aiexr/sdvx-controller/README.md

# Overview
This project is not intended to be a guide. I am documenting how I was able to build a controller as a beginner. This project was primarily a learning experience for me, and I hope to share what I learned.

A Sound Voltex controller itself has 7 buttons and 2 rotary encoders. The photo below shows the controls of a real cabinet.

SOUND VOLTEX controls

<small>image credit: https://ja.wikipedia.org/wiki/%E5%88%A9%E7%94%A8%E8%80%85:Sanjo</small>

# Demonstration
Below is the final product of what I made:

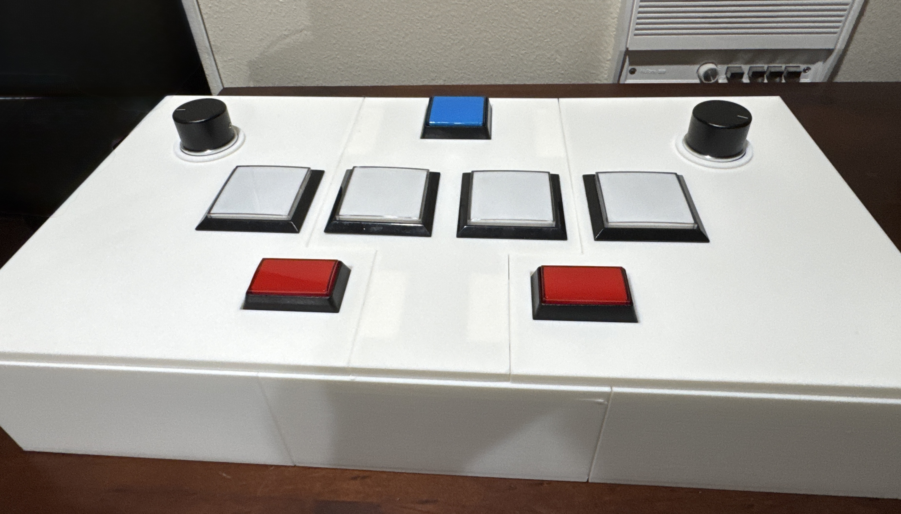
[picture p1: media/controller/complete.jpg]
Completed controller


<table>
  <tr>
    <td width="50%">
      <video src="https://github.com/user-attachments/assets/48bb6534-442d-47c3-9c97-483c5b49c126" width="100%" controls></video>
    </td>
    <td width="50%">
      <video src="https://github.com/user-attachments/assets/058fed3e-3493-4807-bf1f-01e18b2e095d" width="100%" controls></video>
    </td>
  </tr>
</table>

# Process

I chose an [Arduino Leonardo w/ headers](https://store-usa.arduino.cc/products/arduino-leonardo-with-headers) to power all inputs.  

For the **main buttons** (BT-A, BT-B, BT-C, BT-D), I was hoping to buy 60mm buttons to make it more accurate to the actual cabinet, and I found this push button on Adafruit: https://www.adafruit.com/product/6261. 50mm would have worked fine functionally, but I wanted accurate button dimensions. The rest of the parts were purchased on Amazon. 

| Item | Qty | Image |
| --- | --- | --- |
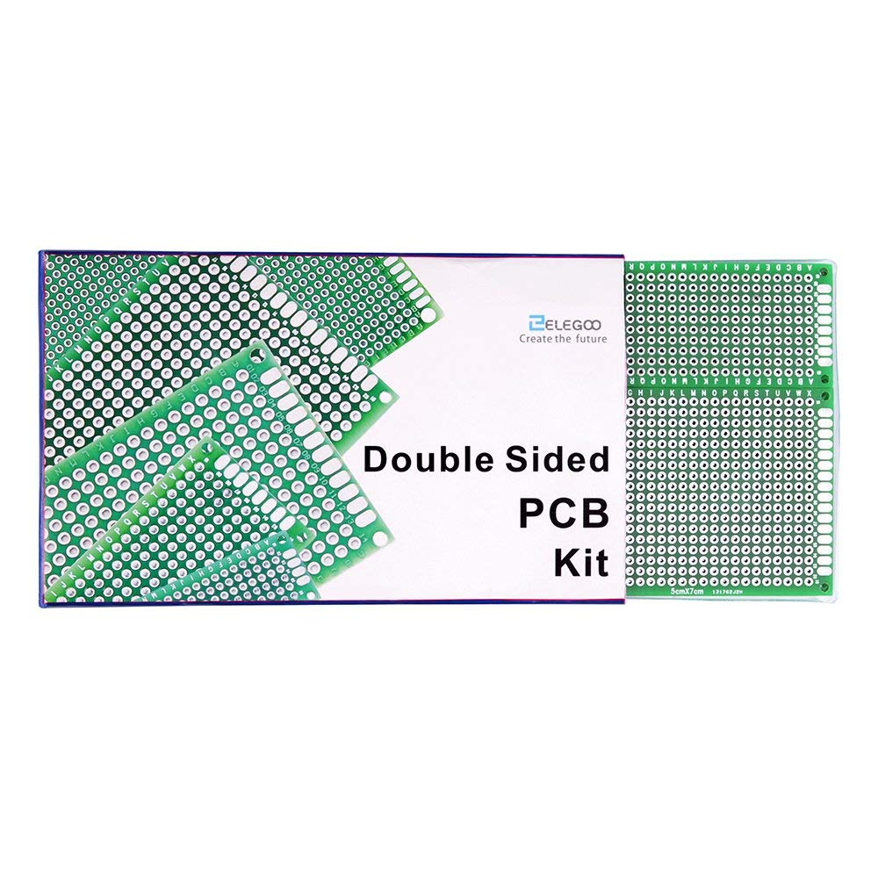
[picture p2: media/products/pcb.png]
PCB
| [Dot PCB](https://www.amazon.com/ELEGOO-Prototype-Soldering-Compatible-Arduino/dp/B072Z7Y19F/) | 1 |  |
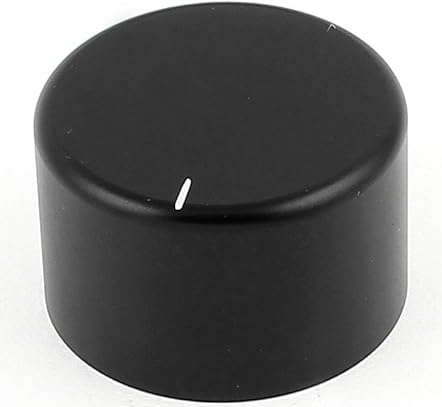
[picture p3: media/products/knob.png]
Knob
| [35x22 knob](https://www.amazon.com/dp/B00X73QARO?ref=ppx_yo2ov_dt_b_fed_asin_title) | 2 |  |
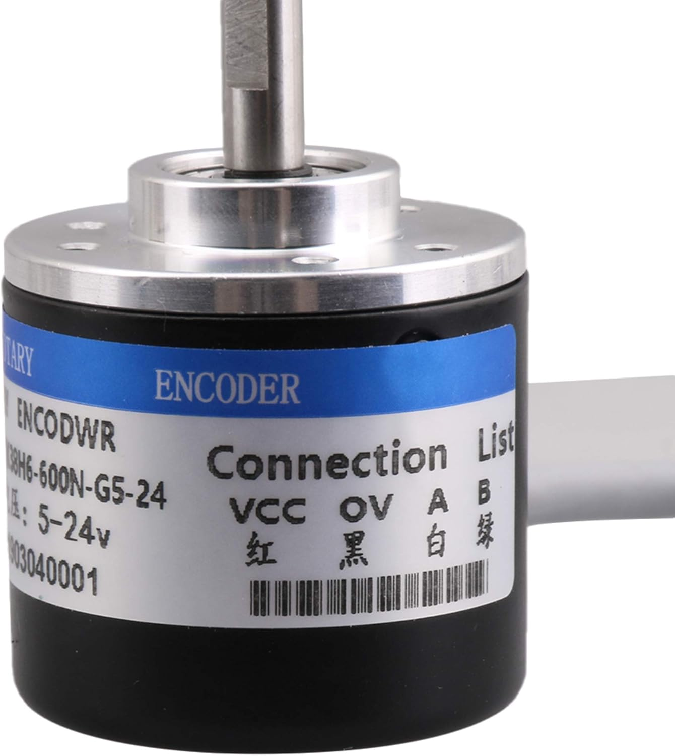
[picture p4: media/products/encoder.png]
Encoder
| [600p/r encoder](https://www.amazon.com/dp/B00UTIFCVA?ref=ppx_yo2ov_dt_b_fed_asin_title) | 2 |  |
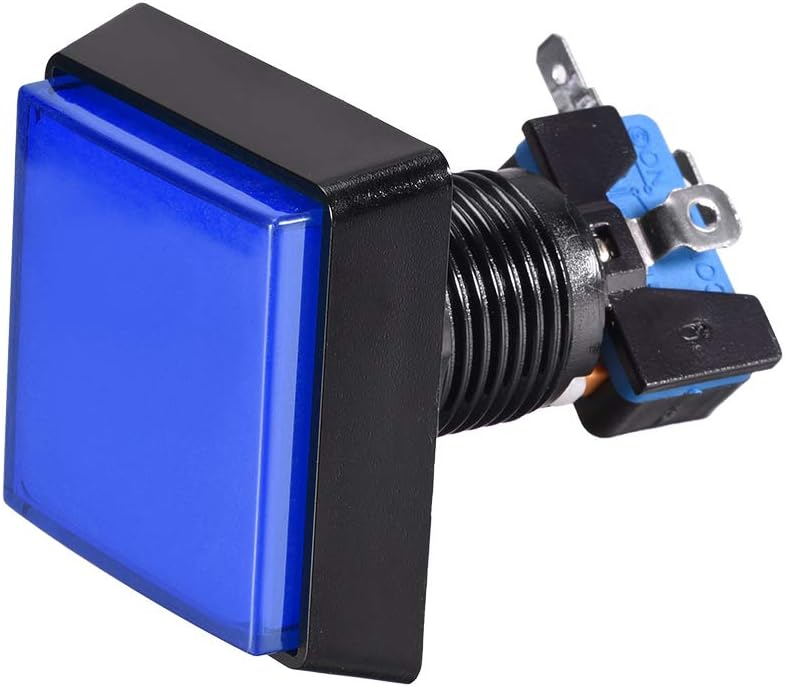
[picture p5: media/products/start.png]
Start button
| [50x50 pushbutton](https://www.amazon.com/dp/B07WNFFPG5?ref=ppx_yo2ov_dt_b_fed_asin_title) | 1 |  |
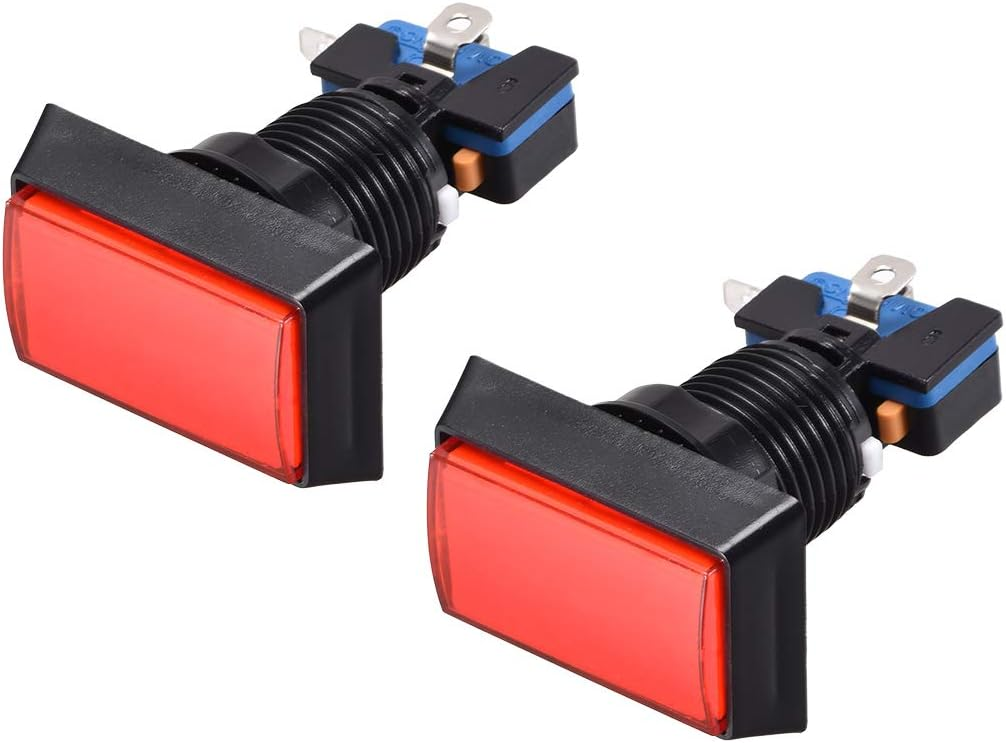
[picture p6: media/products/fx.png]
FX buttons
| [49x33 pushbutton](https://www.amazon.com/dp/B07WQSBSWD?ref=ppx_yo2ov_dt_b_fed_asin_title) | 2 |  |
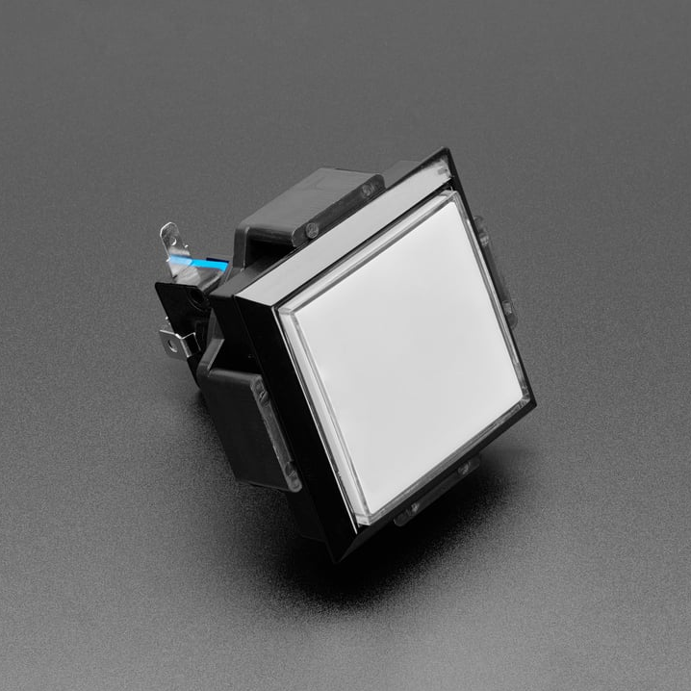
[picture p7: media/products/main-buttons.png]
Main buttons
| [60x60 Adafruit pushbutton](https://www.adafruit.com/product/6261) | 4 |  |

Filament used: ~600g of [Official Creality Hyper PLA Filament 1.75mm, High Speed PLA](https://www.amazon.com/dp/B0C2BJB256?ref=ppx_yo2ov_dt_b_fed_asin_title)

Print settings: 30% infill and 4 walls

Additionally:
- Fusion 360
- a 3D printer (used a Creality K1 Max) 
- Arduino Leonardo (used with headers)

## CAD files and printing
[Link to Fusion360 project](https://a360.co/48BC7ad), fully parametrized. 

Arduino sketch located in [`./CAD/sdvx_controller.ino`](./CAD/sdvx_controller.ino)

It requires this library: https://github.com/MHeironimus/ArduinoJoystickLibrary 

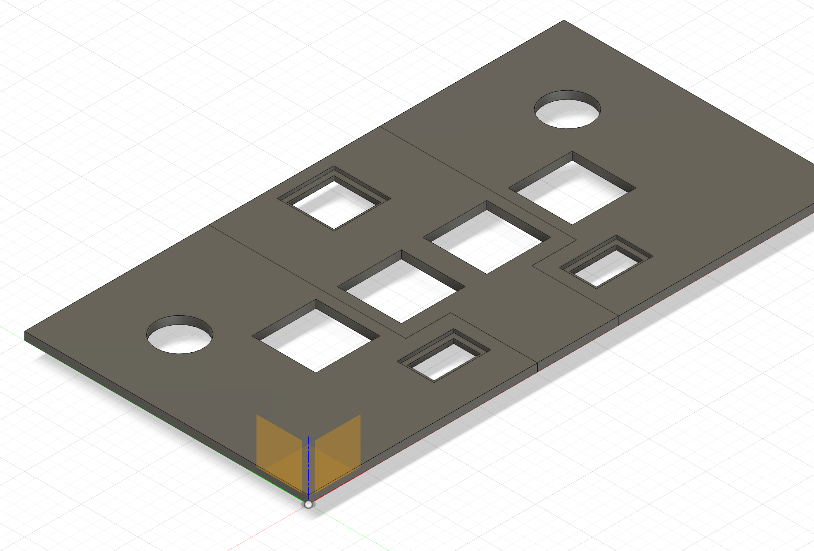
[picture p8: media/screenshots/plate.png]
Button plate


The uppermost part of the board holds the buttons in place. The dimensions of the cutouts on this part of the board are designed to allow each button to snap into place. With the exceptions of BT-A through BT-D (the Adafruit button already had an additional lip on the edge of each pushbutton), each button required an additional shelf to hold the button in place after being placed in its slot. 

This piece is also divided into three separate pieces that can be printed and connected horizontally. 

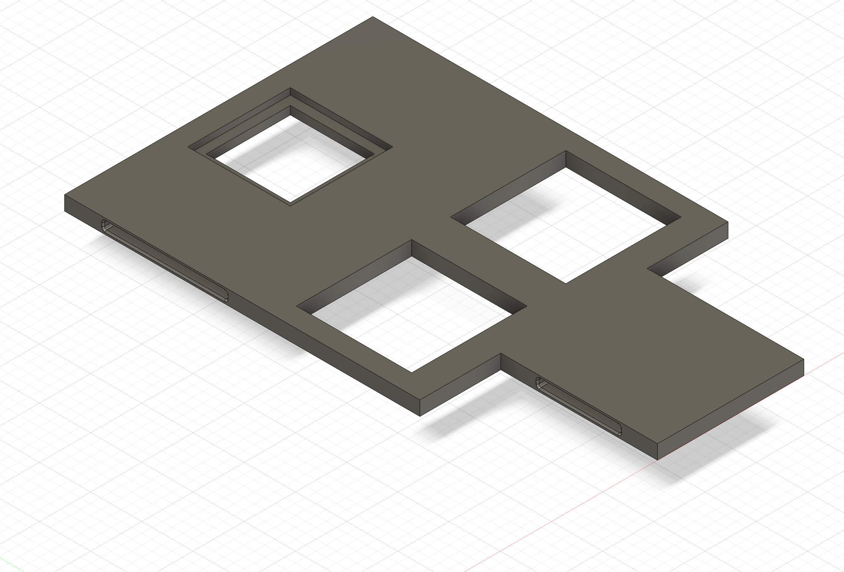
[picture p9: media/screenshots/plate_mid.png]
Button plate with mid piece

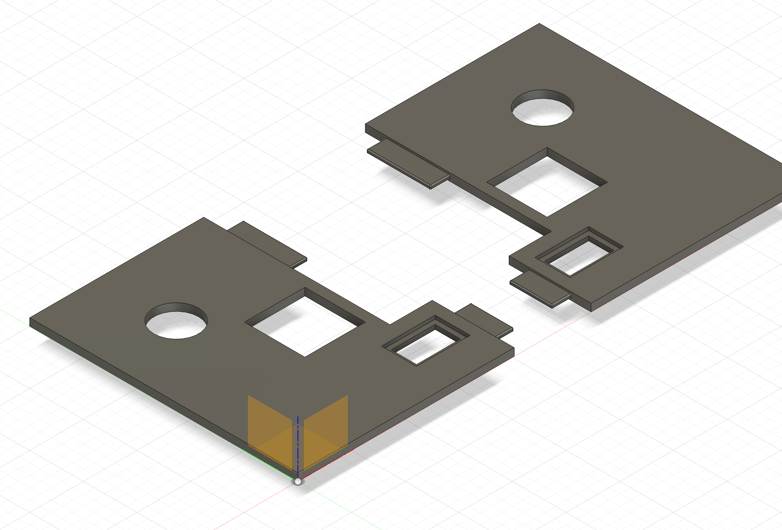
[picture p10: media/screenshots/plate_no_mid.png]
Button plate without mid piece


Shell pieces:

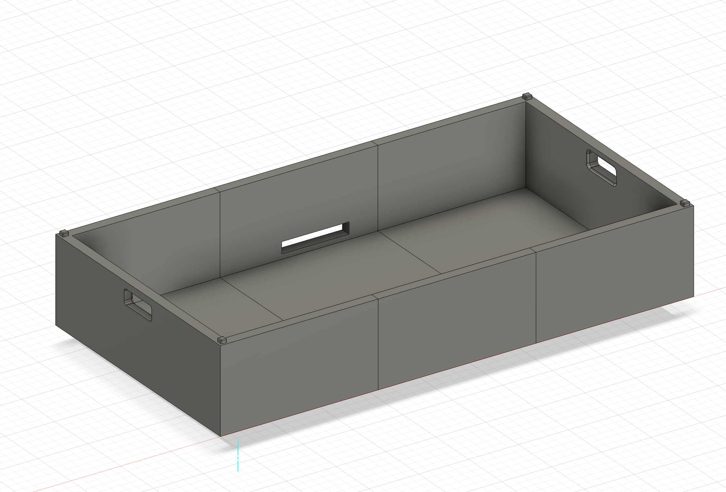
[picture p11: media/screenshots/shell.png]
Shell

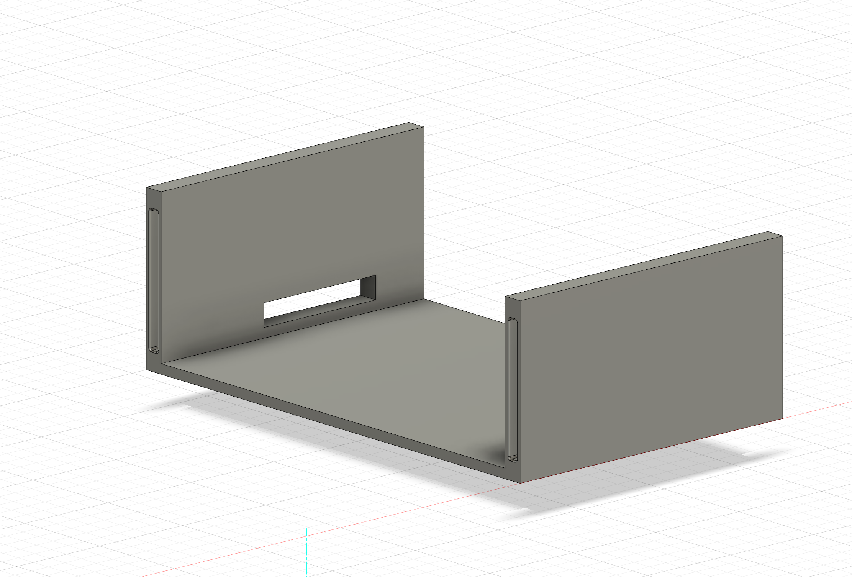
[picture p12: media/screenshots/shell_mid.png]
Shell with middle section

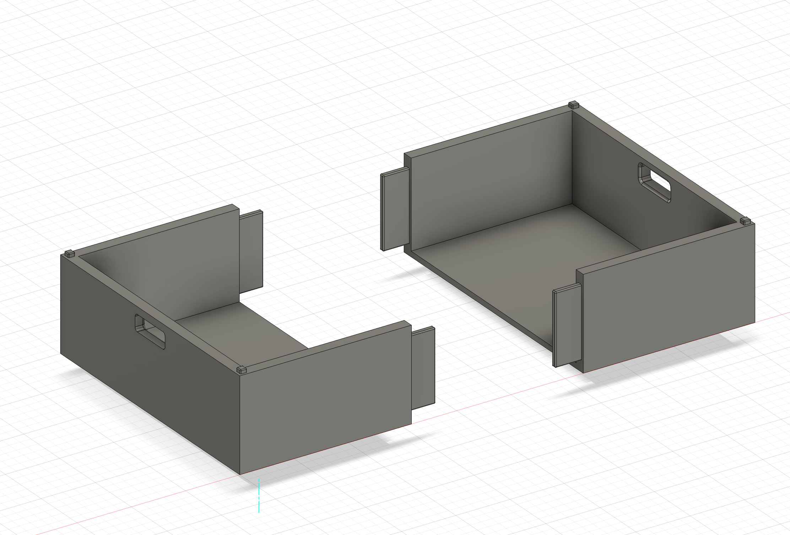
[picture p13: media/screenshots/shell_no_mid.png]
Shell without middle section


The encoder slot is meant to be used with two additional cutouts provided in the Fusion file and uploaded to this repository. 
One piece is an insert that holds the encoder right below the cutout, and another is a small piece that boosts the Z position of the encoder so that it is flush with the board. 

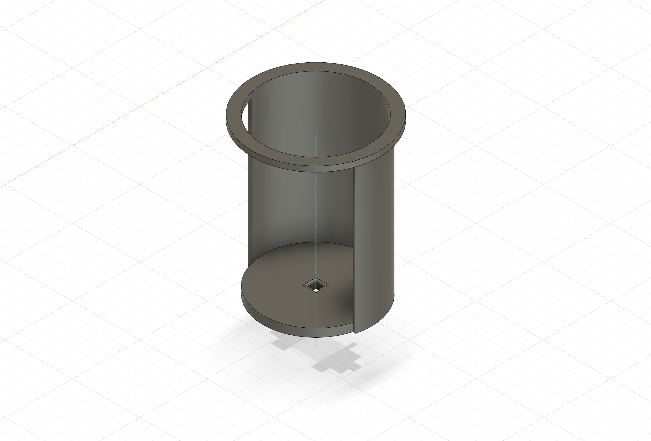
[picture p14: media/screenshots/encoder_shelf.png]
Encoder shelf

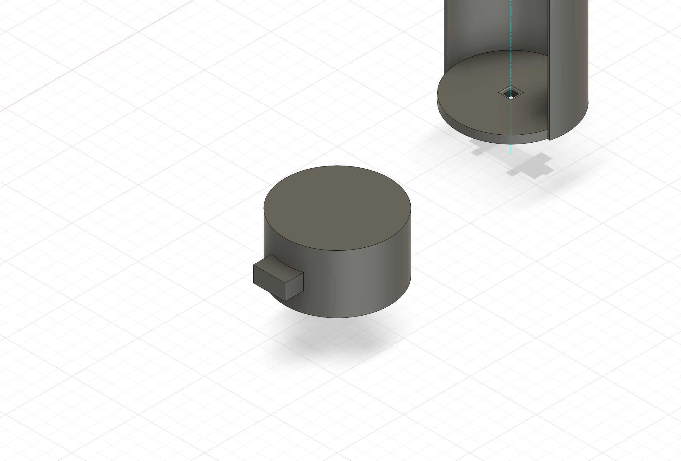
[picture p15: media/screenshots/encoder_step_stool.png]
Encoder step stool

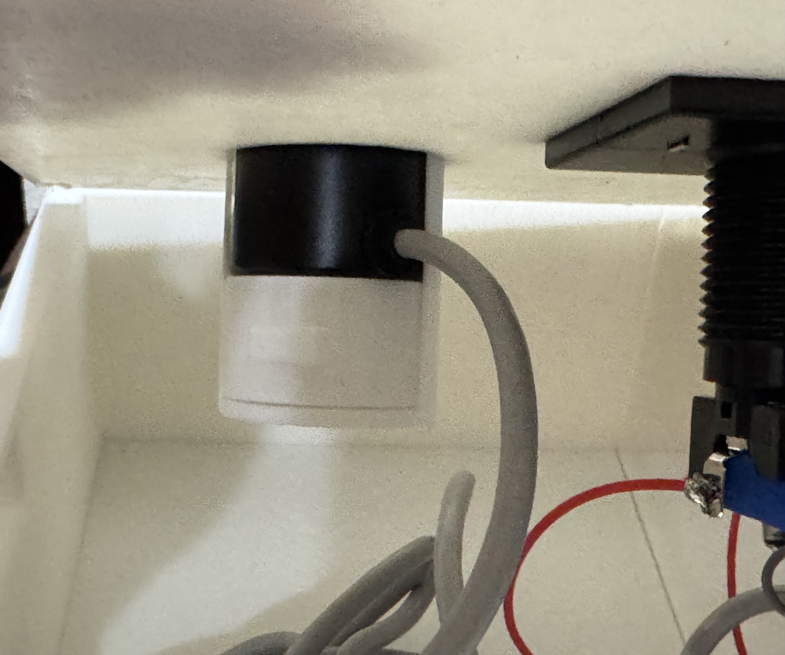
[picture p16: media/controller/encoder shelf.jpg]
Encoder mount


Button and encoder knob sizes, distances, cutouts are all parametrized. There are test cutouts available to print for each of the different buttons and slots. 

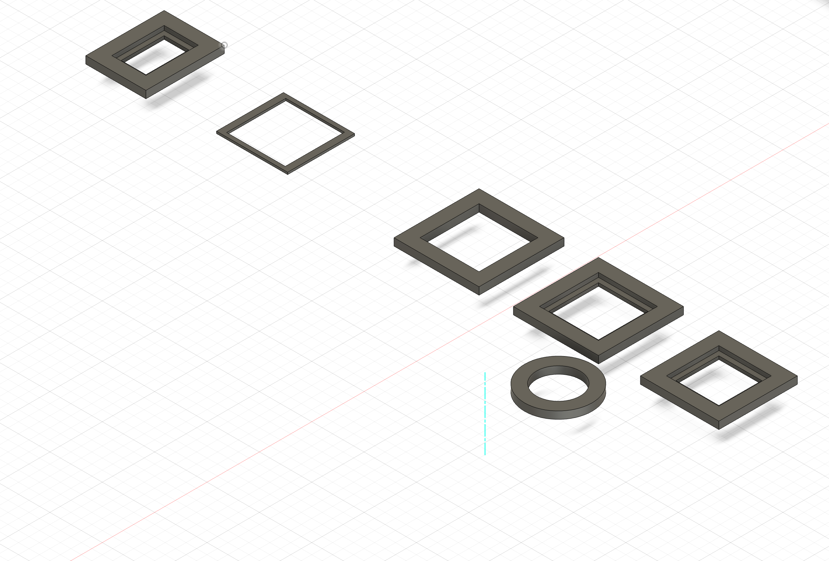
[picture p17: media/screenshots/test_cutouts.png]
Test cutouts


# Wiring

- Button with LED (breadboard)

| COM | GND bus |  |
| --- | --- | --- |
| NO | Arduino pin |  |
| CATHODE | NO |  |
| ANODE | +5V rail |  |
- Encoder (breadboard)

| VCC | +5V rail |  |
| --- | --- | --- |
| GND/black | GND rail |  |
| Green | D9 |  |
| White | D8 |  |

- Arduino

| D13 | BT-1 |
| --- | --- |
| D12 | BT-2 |
| D11 | BT-3 |
| D10 | BT-4 |
| D9 | Left encoder |
| D8 | Left encoder |
| D7 | FX-L |
| D6 | FX-R |
| D5 | Start |
| D4 | Right encoder |
| D3 | Right encoder |

---

## Images

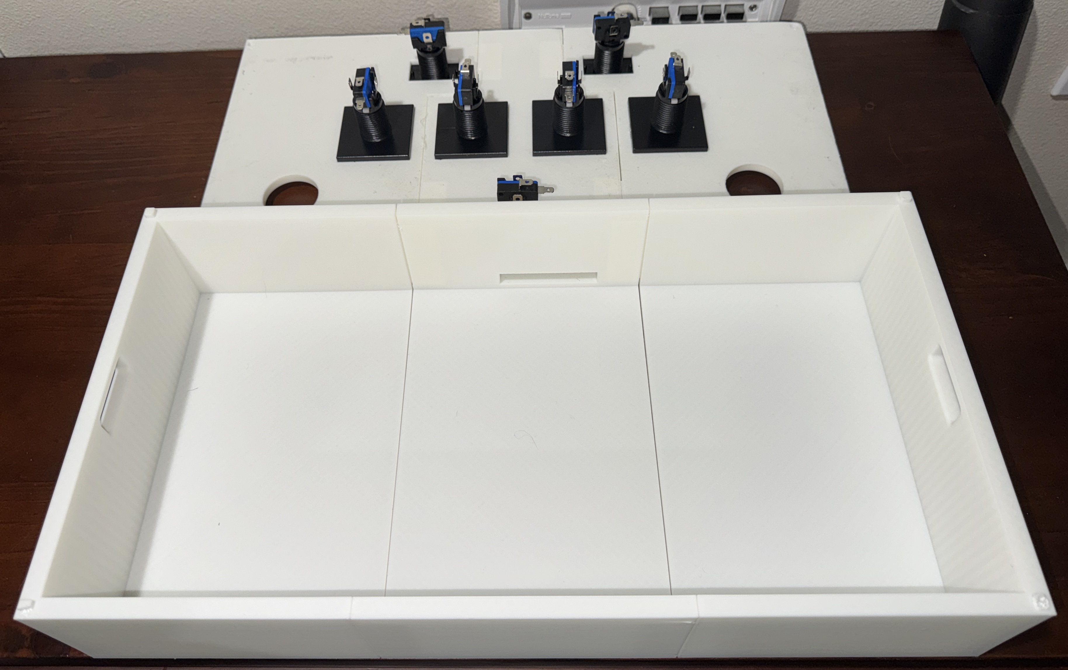
[picture p18: media/controller/shell+top.jpg]
Shell and top

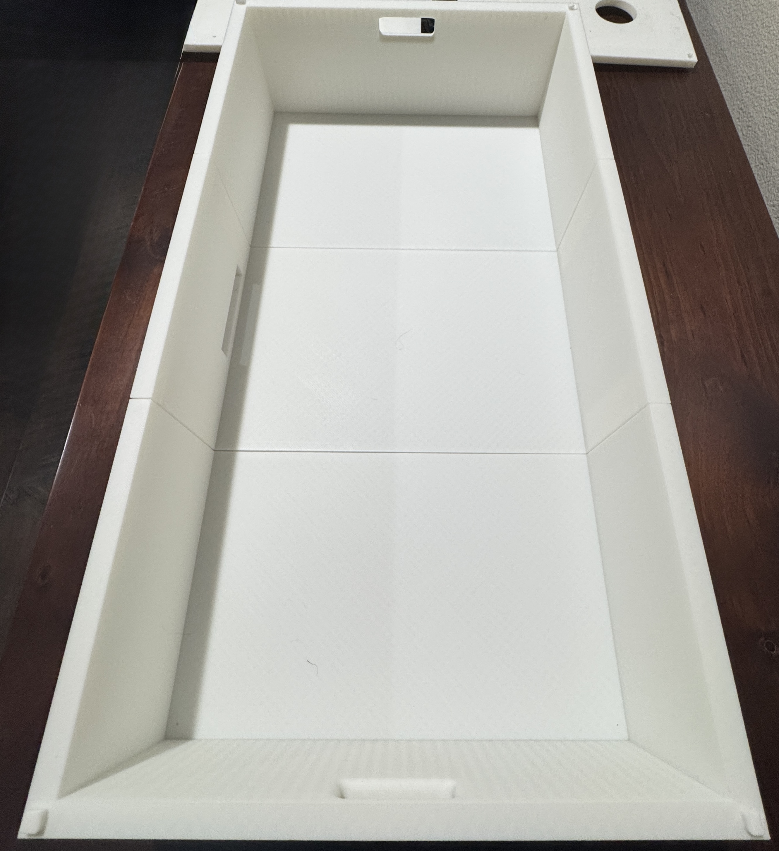
[picture p19: media/controller/long.jpg]
Long view

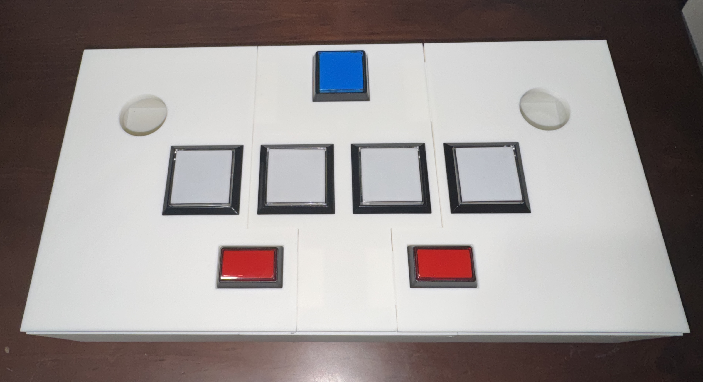
[picture p20: media/controller/top.jpg]
Top-down view

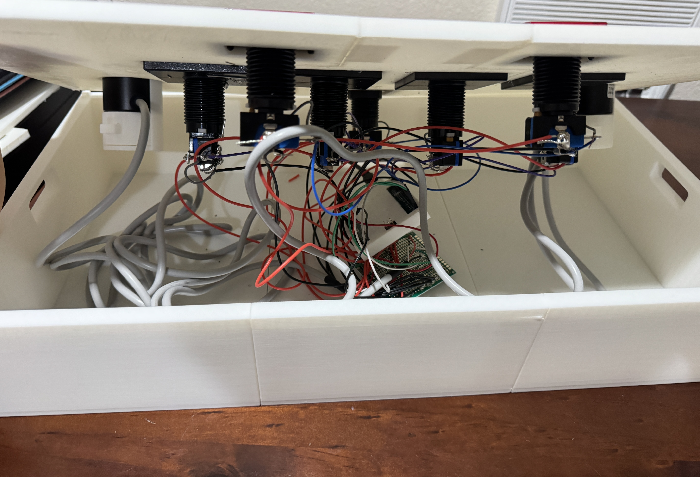
[picture p21: media/controller/wiring.jpg]
Wiring


Afterthoughts:
- The actuation force on the switches that come with each of the buttons is too high, especially for main buttons. This can easily be fixed by using a [lighter microswitch](https://paradisearcadeshop.com/products/ultra-light-touch-microswitch?variant=34672370647202)
- The encoder knob cutout design was not the best and could be made sturdier to prevent any movement when playing
